bobo-nums/ece445/notebooks/colin/images/powermonitor.png

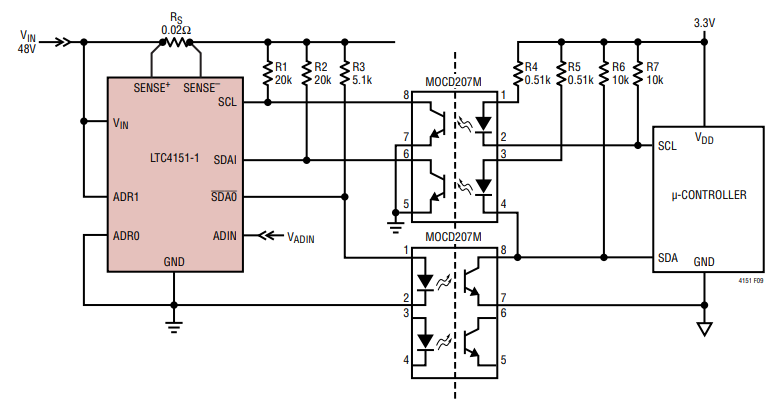
notebooks/colin/images/powermonitor.png
