bobo-nums/ece445/notebooks/colin/images/sepic_schematic.png

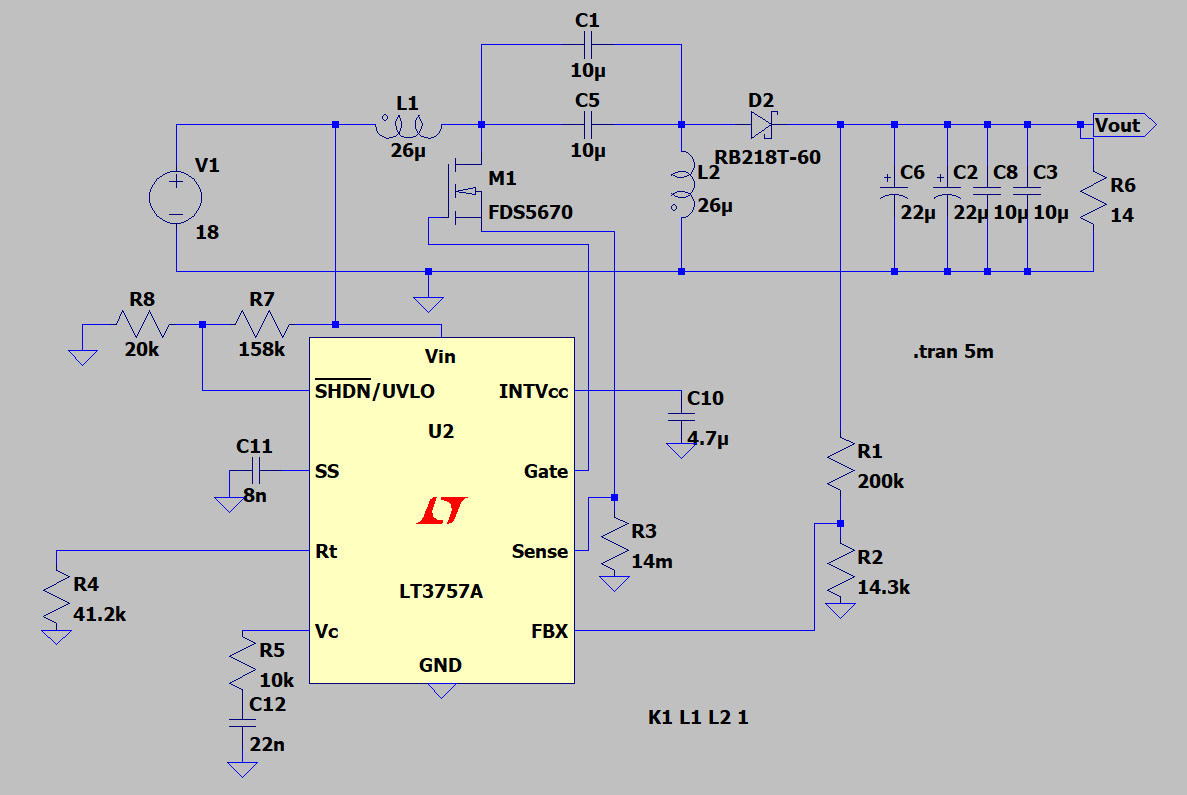
notebooks/colin/images/sepic_schematic.png
