bobo-nums/ece445/notebooks/colin/images/sepic_sim.png

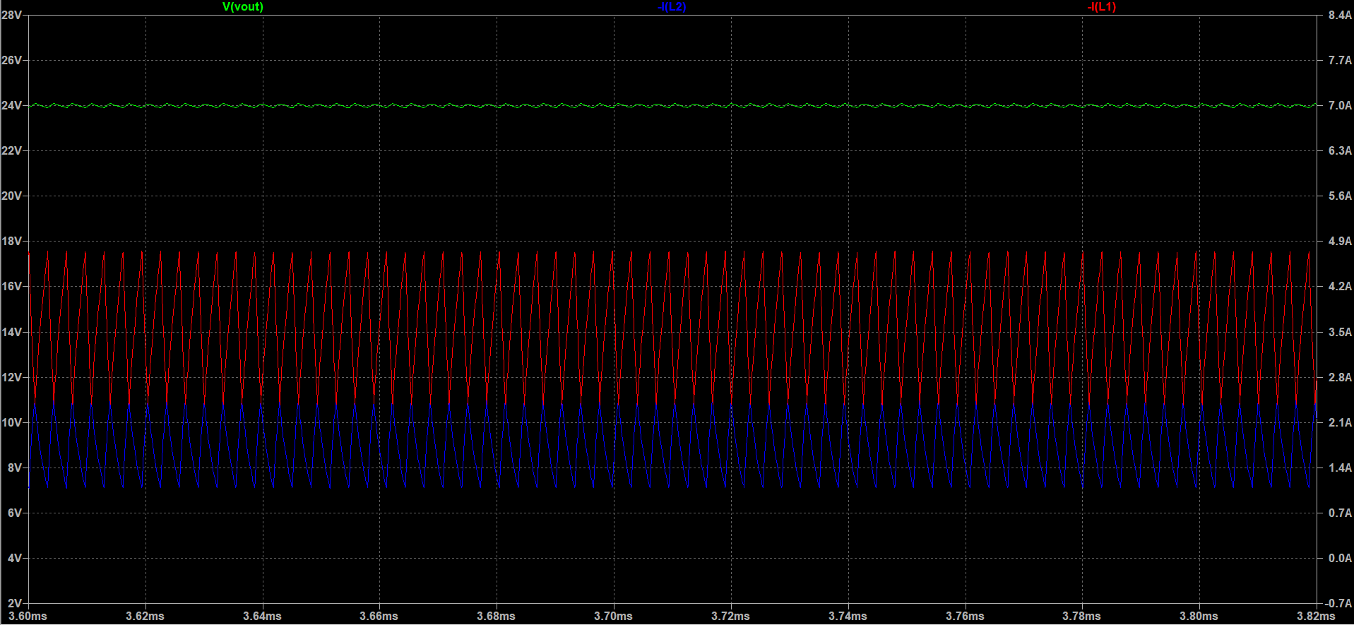
notebooks/colin/images/sepic_sim.png
