bobo-nums/ece445/simulations/3v3 buck/3v3 buck sim waveform.png

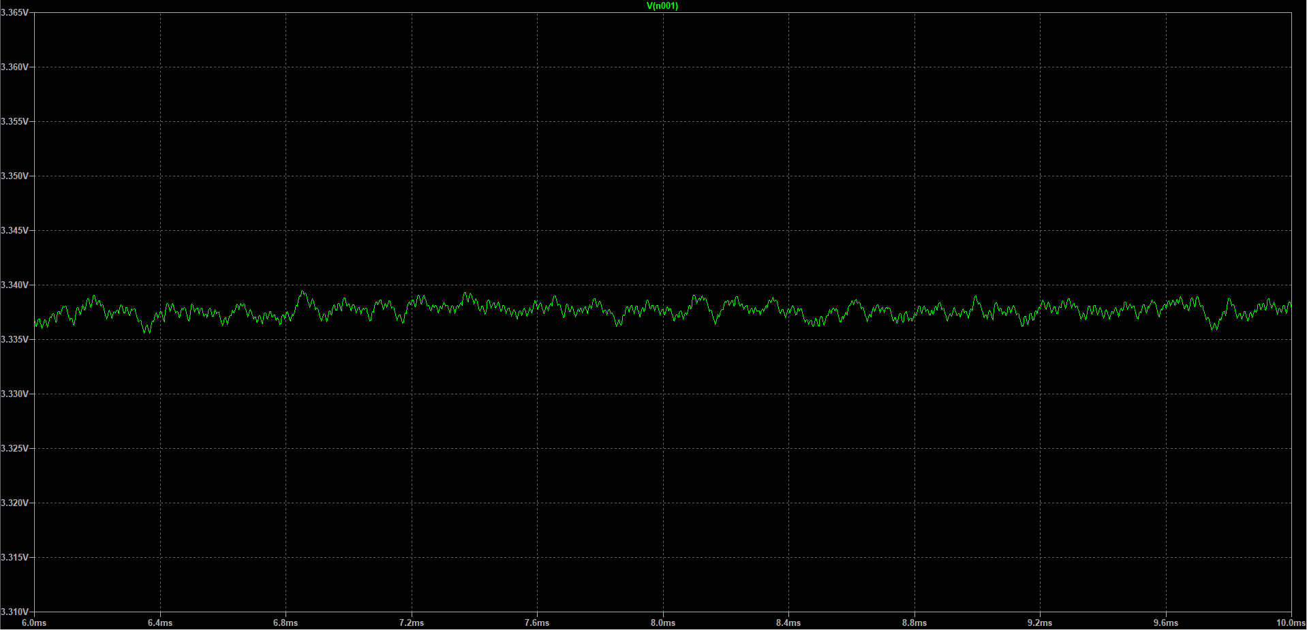
simulations/3v3 buck/3v3 buck sim waveform.png
