bobo-nums/ece445/simulations/5v buck/5v buck sim.png

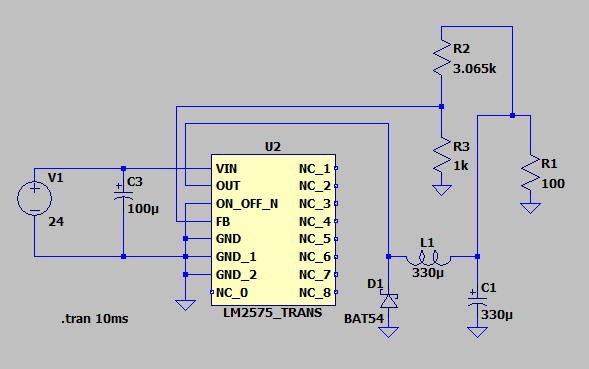
simulations/5v buck/5v buck sim.png
