bobo-nums/ece445/datasheets/components.xlsx

Sheet: Sheet1
Board | Subsystem | Component | Part | Link | Quantity | Comments
 | MCU | 100uF cap | CL31A107MQHNNNE | https://www.digikey.com/en/products/detail/samsung-electro-mechanics/CL31A107MQHNNNE/3887440 | 1
 | MCU | 0.1uF cap | 06036C104KAT4A | https://www.digikey.com/en/products/detail/kyocera-avx/06036C104KAT4A/11244654 | 3
 | MCU | 22pF cap | 06036A220KAT2A | https://www.digikey.com/en/products/detail/kyocera-avx/06036A220KAT2A/1600398 | 2
 | MCU | 10uF cap | JMK107ABJ106MA-T | https://www.digikey.com/en/products/detail/taiyo-yuden/JMK107ABJ106MA-T/4970720 | 1
 | MCU | 10k resistor | RNCP0805FTD10K0 | https://www.digikey.com/en/products/detail/stackpole-electronics-inc/RNCP0805FTD10K0/2240262 | 2
 | MCU | dc/dc | SPBW03F-05 | https://www.mouser.com/ProductDetail/MEAN-WELL/SPBW03F-05?qs=5aG0NVq1C4ygTXk%2FgwDM0Q%3D%3D | 1
 | MCU | button | TS02-66-60-BK-100-LCR-D | https://www.mouser.com/ProductDetail/CUI-Devices/TS02-66-60-BK-100-LCR-D?qs=A6eO%252BMLsxmQEn9GN9b6zGQ%3D%3D | 1
 | MCU | oscillator | AS-16.000-20-EXT | https://www.digikey.com/en/products/detail/raltron-electronics/AS-16-000-20-EXT/10246238 | 1
 | MCU | diode | SBR80520LT1G | https://www.digikey.com/en/products/detail/onsemi/SBR80520LT1G/5969271 | 1
 | MCU
 | MCU
N/A | Sensing | photoresistor | 161 | https://www.digikey.com/en/products/detail/adafruit-industries-llc/161/7244927
N/A | Sensing | Humidity sensor | DHT20 | https://www.sparkfun.com/products/18364
N/A | Sensing | IR sensor | GP2Y0A710K0F | https://www.digikey.com/en/products/detail/sharp-socle-technology/GP2Y0A710K0F/2117639
N/A | MCU | MCU | ATMEGA328-PU | https://www.digikey.com/en/products/detail/microchip-technology/ATMEGA328-PU/2271026 | 1 | Have 2

Sheet: Done
Board | Subsystem | Component | Part | Link | PCB Quantity | Cart Quantity | Purchased | Num
Power | 3.3V buck | 3.3V buck IC | LM2575D2T-3.3R4G | https://www.digikey.com/en/products/detail/onsemi/LM2575D2T-3-3R4G/1476688 | 1 | 1 | Y | 1
Power | 3.3V buck/5V buck | Schottky diode | VS-30WQ04FNTR-M3 | https://www.digikey.com/en/products/detail/vishay-general-semiconductor-diodes-division/VS-30WQ04FNTR-M3/4933687 | 2 | 2 | Y | 1
Power | 3.3V buck/5V buck | 100uF cap | ESY107M050AG3AA | https://www.digikey.com/en/products/detail/kemet/ESY107M050AG3AA/2712537 | 2 | 2 | Y | 1
Power | 3.3V buck/5V buck | 300uH inductor | HCTI-330-5.2 | https://www.digikey.com/en/products/detail/signal-transformer/HCTI-330-5-2/7362985 | 2 | 2 | Y | 1
Power | 3.3V buck/5V buck | 330uF cap | ESY337M025AG8AA | https://www.digikey.com/en/products/detail/kemet/ESY337M025AG8AA/2712527 | 2 | 2 | Y | 1
Power | 5V buck | 5V buck IC | LM2575D2T-5R4G | https://www.digikey.com/en/products/detail/onsemi/LM2575D2T-5R4G/1476691 | 1 | 1 | Y | 1
Power | 24V Converter | 22n cap | 0603ZC223KAT2A | https://www.digikey.com/en/products/detail/kyocera-avx/0603ZC223KAT2A/1600725 | 1 | 2 | Y | 2
Power | 24V Converter | 6.8n cap | 0603B682M500CT | https://www.digikey.com/en/products/detail/walsin-technology-corporation/0603B682M500CT/9354957 | 1 | 2 | Y | 2
Power | 24V Converter | Coupled Inductor | PF0553.153NLT | https://www.digikey.com/en/products/detail/pulse-electronics-power/PF0553-153NLT/2266969 | 1 | 1 | Y | 2
Power | 24V Converter | MOSFET | FDS5670 | https://www.digikey.com/en/products/detail/onsemi/FDS5670/965322 | 1 | 1 | Y | 2
Power | 24V Converter | 10uF Capacitor | CL32A106KLULNNE | https://www.digikey.com/en/products/detail/samsung-electro-mechanics/CL32A106KLULNNE/3888965 | 4 | 5 | Y | 2
Power | 24V Converter | 4.7uF Capacitor | CL21A475KAQNNNE | https://www.digikey.com/en/products/detail/samsung-electro-mechanics/CL21A475KAQNNNE/3886902 | 3 | 4 | Y | 2
Power | 24V Converter | 14mOhm Sense Resistor | WSL2512R0140FTB | https://www.digikey.com/en/products/detail/vishay-dale/WSL2512R0140FTB/9754224 | 1 | 2 | Y | 2
Power | 24V Converter | Schottky diode | SBRT10U60D1-13 | https://www.digikey.com/en/products/detail/diodes-incorporated/SBRT10U60D1-13/5371873 | 1 | 1 | Y | 2
Power | 24V Converter | 22uF Electrolytic Capacitor | UVZ1V220MDD1TD | https://www.digikey.com/en/products/detail/nichicon/UVZ1V220MDD1TD/4342201 | 2 | 2 | Y | 2
Power | 24V Converter | DC/DC Controller | LT3757AIMSE#PBF | https://www.digikey.com/en/products/detail/analog-devices-inc/LT3757AIMSE-PBF/3838483 | 1 | 0 | Y | 2
Power | 24V Converter | 200k res | RMCF1206FT200K | https://www.digikey.com/en/products/detail/stackpole-electronics-inc/RMCF1206FT200K/1759778 | 1 | 2 | Y | 2
Power | 24V Converter | 14.3k res | RMCF0603FT14K3 | https://www.digikey.com/en/products/detail/stackpole-electronics-inc/RMCF0603FT14K3/1761296 | 1 | 10 | Y | 2
Power | 24V Converter | 41.2k res | RMCF0603FT41K2 | https://www.digikey.com/en/products/detail/stackpole-electronics-inc/RMCF0603FT41K2/1761220 | 1 | 10 | Y | 2
Power | 24V Converter | 20k res | RNCP0603FTD20K0 | https://www.digikey.com/en/products/detail/stackpole-electronics-inc/RNCP0603FTD20K0/2240149 | 1 | 2 | Y | 2
Power | 24V Converter | 158k res | RMCF0603FT158K | https://www.digikey.com/en/products/detail/stackpole-electronics-inc/RMCF0603FT158K/1760916 | 1 | 10 | Y | 2
Power | 24V Converter | 10k res | RNCP0603FTD10K0 | https://www.digikey.com/en/products/detail/stackpole-electronics-inc/RNCP0603FTD10K0/2240139 | 1 | 2 | Y | 2
Power | 24V Converter | 4.7u cap | 860160672005 | https://www.digikey.com/en/products/detail/w%C3%BCrth-elektronik/860160672005/5729521 | 2 | 2 | Y | 2
Power | Switching Network | 1 uF capacitor | CL10B105KP8NNNC | https://www.digikey.com/en/products/detail/samsung-electro-mechanics/CL10B105KP8NNNC/3887604 | 4 | 10 | Y | 3
Power | Switching Network | MOSFET | FDD8453LZ | https://www.digikey.com/en/products/detail/onsemi/FDD8453LZ/1768364 | 4 | 4 | Y | 3
Power | Switching Network | Quad High-Side Gate Driver | LT1161IN#PBF | https://www.digikey.com/en/products/detail/analog-devices-inc/LT1161CSW-PBF/889376 | 1 | 1 | Y | 3
Power | Switching Network | 330u cap | UPJ1H331MHD6TN | https://www.digikey.com/en/products/detail/nichicon/UPJ1H331MHD6TN/4319461 | 2 | 2 | Y | 3
Power | Switching Network | 10u cap | GMK325AB7106MMHP | https://www.digikey.com/en/products/detail/taiyo-yuden/GMK325AB7106MMHP/7403987 | 2 | 3 | Y | 3
Power | General | yellow LED | L196L-YC | https://www.digikey.com/en/products/detail/american-opto-plus-led/L196L-YC/12325401 | 1 | 1 | Y | 4
Power | General | 1.5k res | RMCF2512JT1K50 | https://www.digikey.com/en/products/detail/stackpole-electronics-inc/RMCF2512JT1K50/1756956 | 1 | 1 | Y | 4
Power | General | banana connector | 73099-2 | https://www.digikey.com/en/products/detail/pomona-electronics/73099-2/10483465 | 1 | 1 |  | 4
Power | General | banana connector | 73099-0 | https://www.digikey.com/en/products/detail/pomona-electronics/73099-0/10483460 | 1 | 1 |  | 4
Power | Grid Power | AC/DC converter | LM100-23B24 | https://www.digikey.com/en/products/detail/mornsun-america-llc/LM100-23B24/13168375 | 1 | 1 | Y | 5
Power | Power Monitor | Power Monitor (I2C) | LTC4151IMS-1#TRPBF | https://www.digikey.com/en/products/detail/analog-devices-inc/LTC4151IMS-1-TRPBF/1814476 | 1 | 0 | Y | 6
Power | Power Monitor | 0 ohm resistor | HCJ2512ZT0R00 | https://www.digikey.com/en/products/detail/stackpole-electronics-inc/HCJ2512ZT0R00/4357663 | 4 | 5 |  | 6
Power | Power Monitor | Sense Resistor | ERJ-3BWFR020V | https://www.digikey.com/en/products/detail/panasonic-electronic-components/ERJ-3BWFR020V/5647494 | 1 | 2 |  | 6
Power | Power Monitor | optoisolator | MOCD207M | https://www.digikey.com/en/products/detail/fairchild-semiconductor/MOCD207M/281247 | 4 | 4 |  | 6
Power | Power Monitor | MOSFET | FDD8453LZ | https://www.digikey.com/en/products/detail/onsemi/FDD8453LZ/1768364 | 1 | 1 |  | 6
Power | Power Monitor | 20k res | RNCP0603FTD20K0 | https://www.digikey.com/en/products/detail/stackpole-electronics-inc/RNCP0603FTD20K0/2240149 | 2 | 3 |  | 6
Power | Power Monitor | 5.1k res | RMCF0603JT5K10 | https://www.digikey.com/en/products/detail/stackpole-electronics-inc/RMCF0603JT5K10/1757959 | 1 | 10 |  | 6
Power | Power Monitor | 510 res | ESR10EZPJ511 | https://www.digikey.com/en/products/detail/rohm-semiconductor/ESR10EZPJ511/1762828 | 2 | 3 |  | 6
Power | Power Monitor | 10k res | RMCF0805JT10K0 | https://www.digikey.com/en/products/detail/stackpole-electronics-inc/RMCF0805JT10K0/1757762 | 13 | 20 |  | 6
Power | Power Monitor | 33 power res | TEH140M33R0FE | https://www.mouser.com/ProductDetail/Ohmite/TEH140M33R0FE?qs=r5DSvlrkXmJ6291snezuUw%3D%3D | 1 | 1 |  | 6
Power | Power Monitor | 100k res | RMCF1206JT100K | https://www.digikey.com/en/products/detail/stackpole-electronics-inc/RMCF1206JT100K/1757423 | 2 | 10 |  | 6
Power | Power Monitor | power res heat sink | 588-E2A-T247-38E | https://www.mouser.com/ProductDetail/588-E2A-T247-38E | 1 | 1 |  | 6
Lights | Lights | Relay | 1462041-7 | https://www.digikey.com/en/products/detail/te-connectivity-potter-brumfield-relays/1462041-7/2126941 | 1 | 1 |  | 7
Lights | Lights | MOSFET | FDD8453LZ | https://www.digikey.com/en/products/detail/onsemi/FDD8453LZ/1768364 | 4 | 4 |  | 7
Lights | Lights | Screw terminal | TB002-500-02BE | https://www.digikey.com/en/products/detail/cui-devices/TB002-500-02BE/10064069 | 4 | 4 |  | 7
Lights | Lights | Flyback diode | SBR1A20T5-7 | https://www.digikey.com/en/products/detail/diodes-incorporated/SBR1A20T5-7/6051869 | 1 | 2 |  | 7
Lights | Lights | 10k res | RMCF0805JT10K0 | https://www.digikey.com/en/products/detail/stackpole-electronics-inc/RMCF0805JT10K0/1757762 | 6 | 10 |  | 7
Lights | Lights | optoisolator | MOCD207M | https://www.digikey.com/en/products/detail/fairchild-semiconductor/MOCD207M/281247 | 2 | 2 |  | 7
Power | Buttons | button | GPTS203211B | https://www.digikey.com/en/products/detail/cw-industries/GPTS203211B/3190590 | 2 | 2 |  | 8
