bobo-nums/ece445/(list of files, cad)

Other CAD files:
physical design/traffic light.ipt
