bobo-nums/ece445/simulations/another switching network/another switching network.asc

C1: cap; 1µ
C2: cap; 1µ
C3: cap; 1µ
C4: cap; 1µ
C5: polcap; 330µ; V=35 Irms=1.06 Rser=0.06 Lser=0 mfg="Nichicon" pn="UPL1V331MPH" type="Al electrolytic"
C6: polcap; 330µ; V=35 Irms=1.06 Rser=0.06 Lser=0 mfg="Nichicon" pn="UPL1V331MPH" type="Al electrolytic"
C7: cap; 10µ; V=35 Irms=0 Rser=0 Lser=0 mfg="Murata" pn="GRM21BR6YA106KE43" type="X5R"
C8: cap; 10µ; V=35 Irms=0 Rser=0 Lser=0 mfg="Murata" pn="GRM21BR6YA106KE43" type="X5R"
M1: nmos; BSC060N10NS3
M2: nmos; BSC060N10NS3
M3: nmos; BSC060N10NS3
M4: nmos; BSC060N10NS3
R1: res; 15
U1: LT1161
U2: LT1161
V1: voltage; PWL(0 0 5m 0 5.01m 0 9.99m 0 10m 5)
V2: voltage; 24
V4: voltage; 24
V6: voltage; PWL(0 0 4.99m 0 5m 5 9.99m 5 10m 0)
Named nets: 0
.tran 15m
