bobo-nums/ece445/simulations/24v sepic/24v sepic.asc

C1: cap; 10µ; V=25 Irms=18.5 Rser=0.00262245 Lser=0 mfg="KEMET" pn="C1210C106K3RAC" type="X7R"
C2: polcap; 22µ; V=35 Irms=65m Rser=2.3 Lser=0 mfg="Nichicon" pn="UPR1V220MAH" type="Al electrolytic"
C3: cap; 10µ; V=35 Irms=8.06 Rser=0.000077565 Lser=0
C5: cap; 10µ; V=25 Irms=18.5 Rser=0.00262245 Lser=0 mfg="KEMET" pn="C1210C106K3RAC" type="X7R"
C6: polcap; 22µ; V=35 Irms=65m Rser=2.3 Lser=0 mfg="Nichicon" pn="UPR1V220MAH" type="Al electrolytic"
C8: cap; 10µ; V=35 Irms=8.06 Rser=0.00577565 Lser=0 mfg="KEMET" pn="C1210C106K6PAC" type="X5R"
C10: cap; 4.7µ; V=4 Irms=9.29 Rser=0.00646575 Lser=0 mfg="KEMET" pn="C0603C475K7PAC" type="X5R"
C11: cap; 6.8n
C12: cap; 22n
D2: schottky; RB218T-60
L1: ind2; 28µ; Rser=48m
L2: ind2; 28µ; Rser=48m
M1: nmos; FDS5670
R1: res; 200k
R2: res; 14.3k
R3: res; 14m; pwr=1
R4: res; 41.2k
R5: res; 10k
R6: res; 14
R7: res; 158k
R8: res; 20k
U2: LT3757A
V1: voltage; 18
Named nets: Vout, 0
.tran 5m
K1 L1 L2 1
