bobo-nums/ece445/simulations/new switching network/Draft1.asc

C1: cap; 1µ
C2: cap; 1µ
C3: cap; 1µ
C4: cap; 1µ
C5: cap; 220µ
C6: cap; 220µ
D1: schottky; RBQ30TB45B
D2: schottky; RBQ30TB45B
M1: nmos; BSC060N10NS3
M2: nmos; BSC060N10NS3
M3: nmos; BSC060N10NS3
M4: nmos; BSC060N10NS3
R1: res; 14
U1: LT1161
U2: LT1161
V1: voltage; PWL(0 0 5m 0 5.01m 0 9.99m 0 10m 5)
V2: voltage; 24
V3: voltage; PWL(0 5 5m 5 9.99m 5 10m 0)
V4: voltage; 24
V5: voltage; PWL(0 0 5m 0 5.01m 0 9.99m 0 10m 5)
V6: voltage; PWL(0 5 5m 5 9.99m 5 10m 0)
Named nets: 0
.tran 15m
