bobo-nums/ece445/simulations/new switching network/new switching network.asc

C1: cap; 15µ; Rser=0.002
C2: polcap; 470µ; V=450 Irms=1.85 Rser=0.085 Lser=9.61067n mfg="Würth Elektronik" pn="861141486024 WCAP-AI3H 35x50" type="Al electrolytic"
C3: cap; 15µ; Rser=0.002
C6: polcap; 470µ; V=450 Irms=1.85 Rser=0.085 Lser=9.61067n mfg="Würth Elektronik" pn="861141486024 WCAP-AI3H 35x50" type="Al electrolytic"
D3: zener; BZX84C12VL
D4: zener; BZX84C12VL
Q1: nmos; BSC060N10NS3
Q2: nmos; BSC060N10NS3
Q3: nmos; BSC060N10NS3
Q4: nmos; BSC060N10NS3
R1: res; 10k
R2: res; 100k
R3: res; 10k
R4: res; 100k
Rload: res; 24
U1: LTC4359
U2: LTC4359
V1: voltage; 24
V2: voltage; 24
V3: voltage; PWL(0 5 5m 5 5.01m 0)
V4: voltage; PWL(0 0 5m 0 5.01m 5 10m 5)
Named nets: 0
.tran 20m
