bobo-nums/ece445/simulations/5v buck/5v buck.asc

C1: polcap; 330µ
C3: polcap; 100µ
D1: schottky; BAT54
L1: ind; 330µ
R1: res; 100
R2: res; 3.065k
R3: res; 1k
U2: LM2575_TRANS
V1: voltage; 24
Named nets: 0
.tran 10ms
