bobo-nums/ece445/simulations/switching network/switching network.asc

C1: cap; 1.5µ
C2: cap; 1.5µ
D1: zener; TFZ24B
D2: schottky; RBR20BM60A
D3: zener; BZX84C12VL
D4: zener; TFZ24B
D5: schottky; RBR20BM60A
D6: zener; BZX84C12VL
M1: nmos; AONS66612
M2: nmos; BSZ100N06LS3
M3: nmos; AONS66612
M4: nmos; BSZ100N06LS3
R1: res; 1k
R2: res; 100k
R3: res; 1k
R4: res; 100k
R5: res; 10k
R6: res; 10k
S1: sw
SW: sw
U1: LTC4359
U2: LTC4359
V1: voltage; 24
V2: voltage; 24
V3: voltage; PULSE(5 0 0 .5m .5m 1m)
V4: voltage; 5
V5: voltage; PULSE(0 5 0 .5m .5m 1m)
V6: voltage; 5
Named nets: 0
.tran 5m
.model SW SW(Ron=1 Roff=1Meg Vt=.5 Vh=-.4)
