bobo-nums/ece445/kicad/buck_board/buck_board/buck_board.kicad_pcb

## KiCad design kicad/buck_board/buck_board/buck_board.kicad_pcb (2022-03-30)

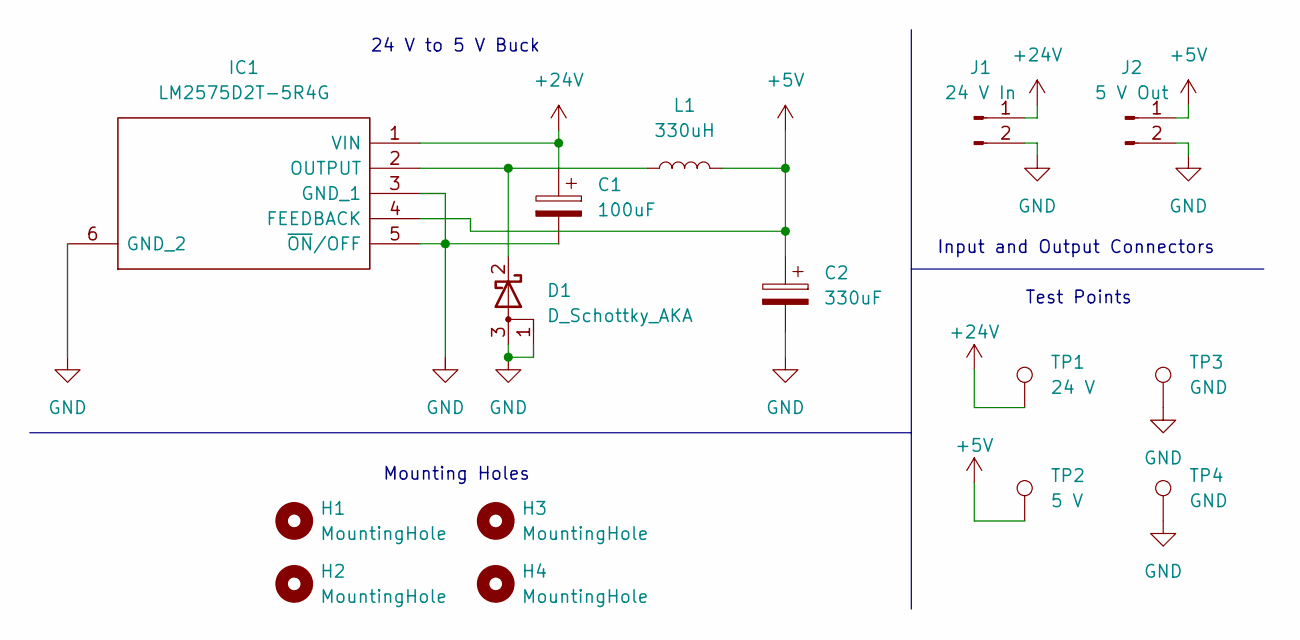
[picture p58: schematic buck_board.kicad_sch]

Parts:
C1: 100uF; CP_Radial_D8.0mm_P3.50mm
C2: 330uF; CP_Radial_D8.0mm_P3.50mm
D1: D_Schottky_AKA; TO-252-2
H1, H2, H3, H4: MountingHole; MountingHole_3.2mm_M3
IC1: LM2575D2T-5R4G; NCP5663DSADJR4G; Mouser Part Number 863-LM2575D2T-5R4G
J1: 24 V In; PinHeader_1x02_P2.54mm_Vertical
J2: 5 V Out; PinHeader_1x02_P2.54mm_Vertical
L1: 330uH; L_Toroid_Vertical_L31.8mm_W15.9mm_P13.50mm_Bourns_5700
TP1: 24 V; TestPoint_THTPad_D2.0mm_Drill1.0mm
TP2: 5 V; TestPoint_THTPad_D2.0mm_Drill1.0mm
TP3, TP4: GND; TestPoint_THTPad_D2.0mm_Drill1.0mm

Connections:
+5V: C2.1, IC1.4 (FEEDBACK), J2.1, L1.2, TP2.1
+24V: C1.1, IC1.1 (VIN), J1.1, TP1.1
GND: C1.2, C2.2, D1.1 (A), D1.3 (A), IC1.3 (GND_1), IC1.5 (~ON/OFF), IC1.6 (GND_2), J1.2, J2.2, TP3.1, TP4.1
unnamed: D1.2 (K), IC1.2 (OUTPUT), L1.1

Notes on the sheet:
Input and Output Connectors
Test Points
Mounting Holes
24 V to 5 V Buck

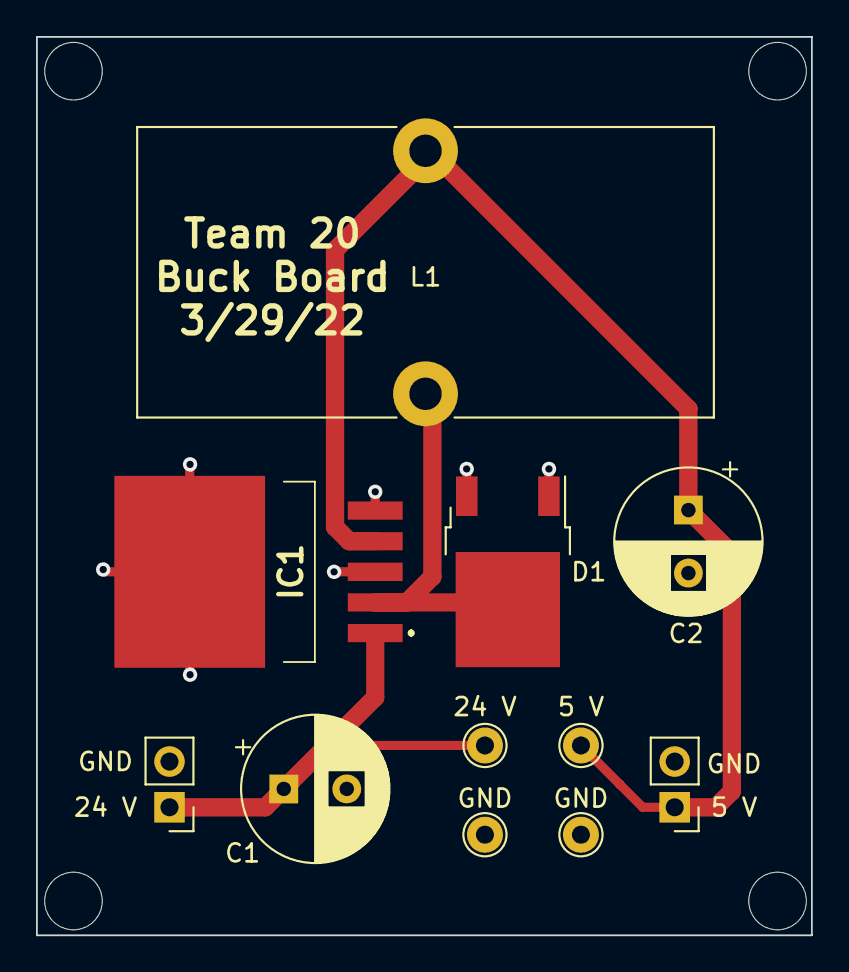
[picture p59: board buck_board.kicad_pcb from above]

Board: 2 copper layers, 43.1 x 49.9 mm, 15 parts (0 on the bottom side), 4 nets.
