bobo-nums/ece445/kicad/light_board/light_board.kicad_pcb

## KiCad design kicad/light_board/light_board.kicad_pcb (2022-03-29)

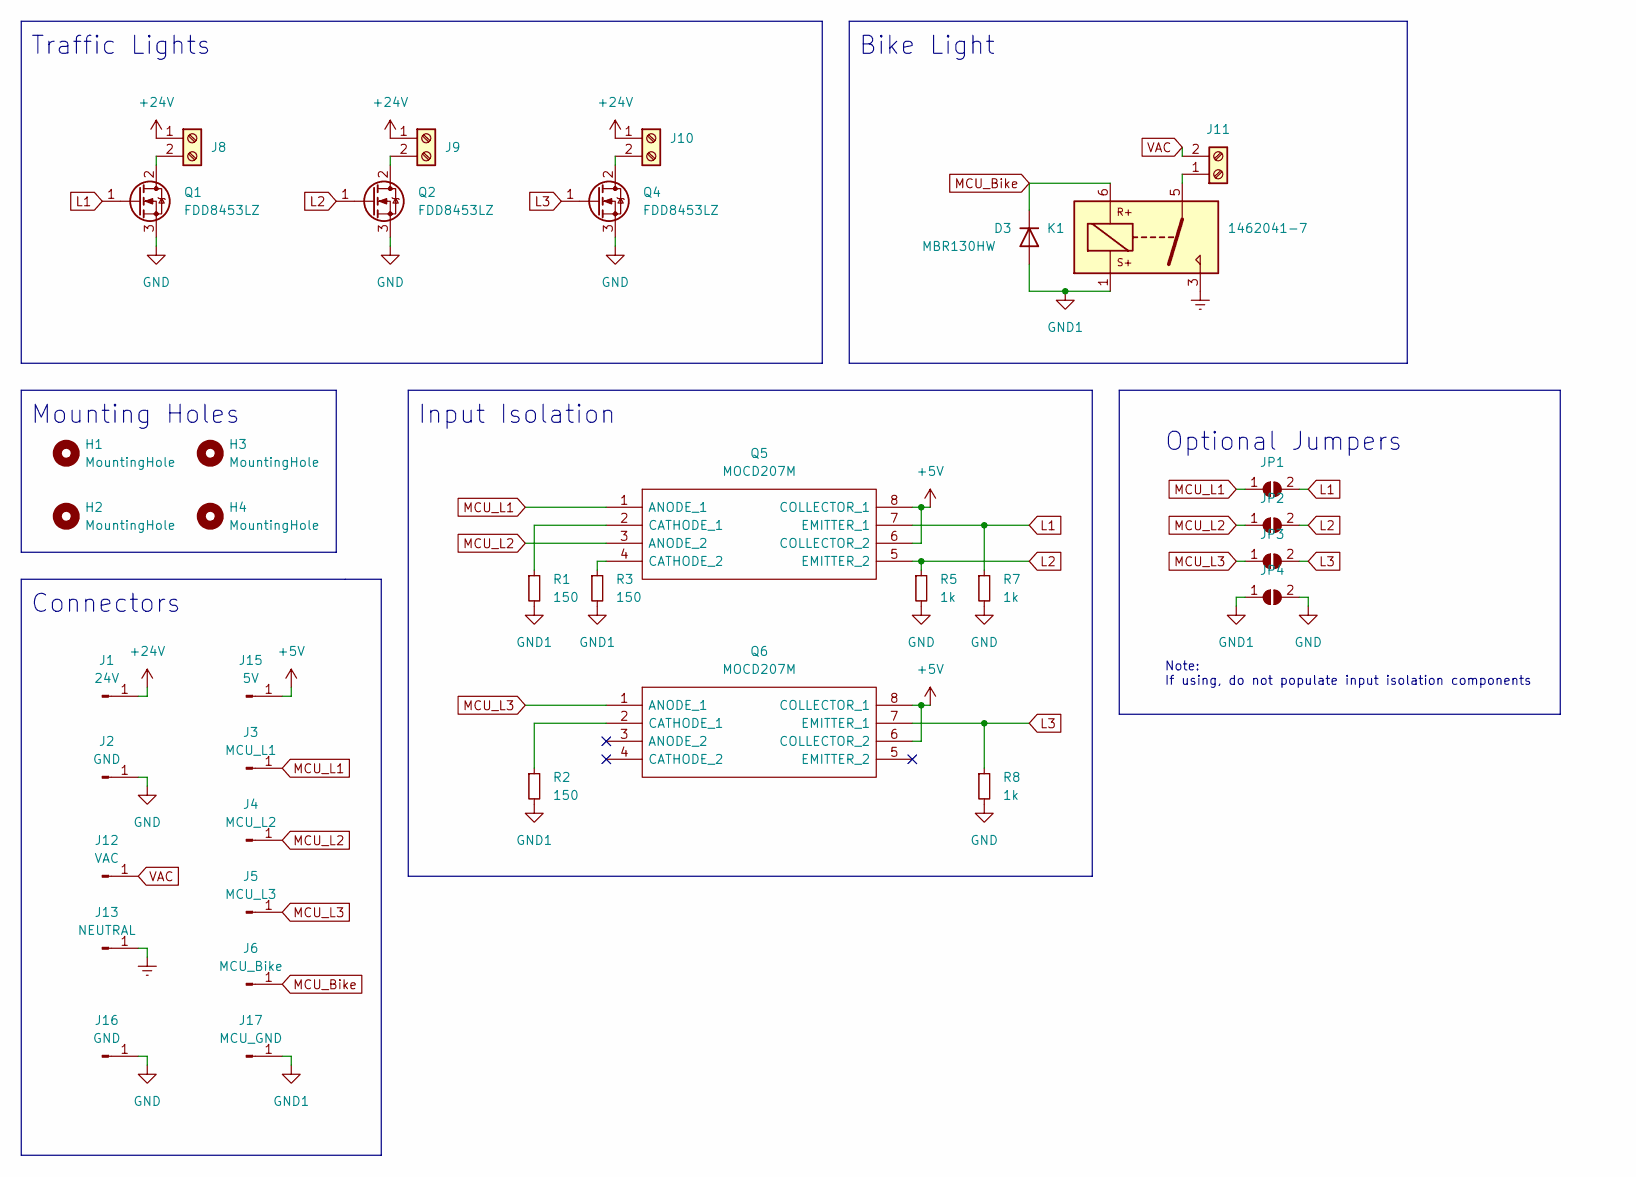
[picture p60: schematic light_board.kicad_sch]

Parts:
D3: MBR130HW; D_SOD-123
H1, H2, H3, H4: MountingHole; MountingHole_3.5mm
J1: 24V; hole
J2: GND; hole
J3: MCU_L1; PinHeader_1x01_P2.54mm_Vertical
J4: MCU_L2; PinHeader_1x01_P2.54mm_Vertical
J5: MCU_L3; PinHeader_1x01_P2.54mm_Vertical
J6: MCU_Bike; PinHeader_1x01_P2.54mm_Vertical
J8, J9, J10, J11: Screw_Terminal_01x02; TerminalBlock_Altech_AK300-2_P5.00mm
J12: VAC; hole
J13: NEUTRAL; hole
J15: 5V; PinHeader_1x01_P2.54mm_Vertical
J16: GND; PinHeader_1x01_P2.54mm_Vertical
J17: MCU_GND; PinHeader_1x01_P2.54mm_Vertical
JP1, JP2, JP3, JP4: SolderJumper_2_Open; SolderJumper-2_P1.3mm_Open_TrianglePad1.0x1.5mm
K1: 1462041-7
Q1, Q2, Q4: FDD8453LZ; TO-252-2
Q5, Q6: MOCD207M; SOIC-8_3.9x4.9mm_P1.27mm; Mouser Part Number 512-MOCD207M
R1, R2, R3: 150; R_0603_1608Metric
R5, R7, R8: 1k; R_0603_1608Metric

Connections:
+5V: J15.1, Q5.6 (COLLECTOR_2), Q5.8 (COLLECTOR_1), Q6.6 (COLLECTOR_2), Q6.8 (COLLECTOR_1)
+24V: J1.1, J8.1, J9.1, J10.1
Earth: J13.1, K1.3
GND: J2.1, J16.1, JP4.2 (B), Q1.3 (S), Q2.3 (S), Q4.3 (S), R5.2, R7.2, R8.2
GND1: D3.2 (A), J17.1, JP4.1 (A), K1.1, R1.2, R2.2, R3.2
L1: JP1.2 (B), Q1.1 (G), Q5.7 (EMITTER_1), R7.1
L2: JP2.2 (B), Q2.1 (G), Q5.5 (EMITTER_2), R5.1
L3: JP3.2 (B), Q4.1 (G), Q6.7 (EMITTER_1), R8.1
MCU_Bike: D3.1 (K), J6.1, K1.6
MCU_L1: J3.1, JP1.1 (A), Q5.1 (ANODE_1)
MCU_L2: J4.1, JP2.1 (A), Q5.3 (ANODE_2)
MCU_L3: J5.1, JP3.1 (A), Q6.1 (ANODE_1)
unnamed: J8.2, Q1.2 (D)
unnamed: J9.2, Q2.2 (D)
unnamed: J10.2, Q4.2 (D)
unnamed: J11.1, K1.5
unnamed: Q5.2 (CATHODE_1), R1.1
unnamed: Q5.4 (CATHODE_2), R3.1
unnamed: Q6.2 (CATHODE_1), R2.1
VAC: J11.2, J12.1

Notes on the sheet:
Input Isolation
Mounting Holes
Connectors
Optional Jumpers
Bike Light
Note: If using, do not populate input isolation components
Traffic Lights

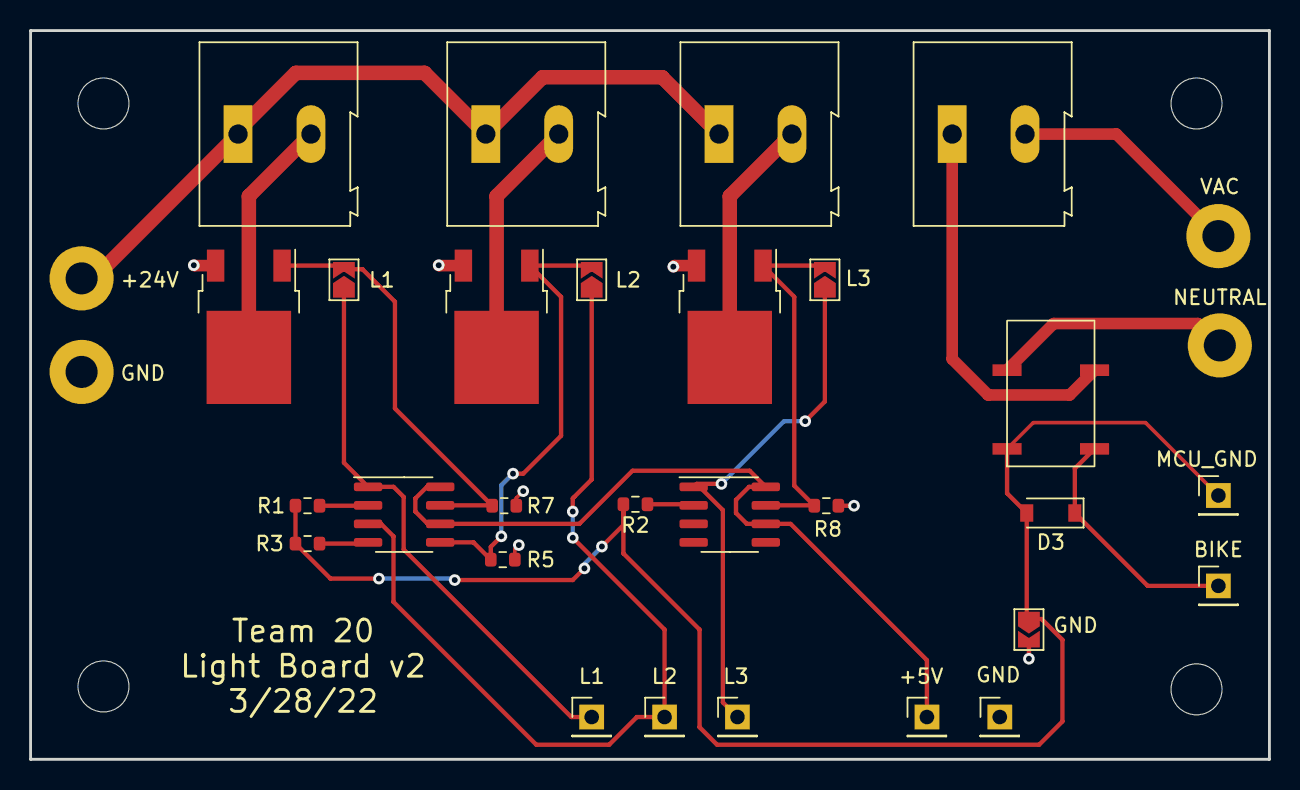
[picture p61: board light_board.kicad_pcb from above]

Board: 2 copper layers, 85.0 x 50.0 mm, 36 parts (0 on the bottom side), 20 nets.
