bobo-nums/ece445/kicad/power_board/power_board.kicad_pcb

## KiCad design kicad/power_board/power_board.kicad_pcb (2022-03-29)

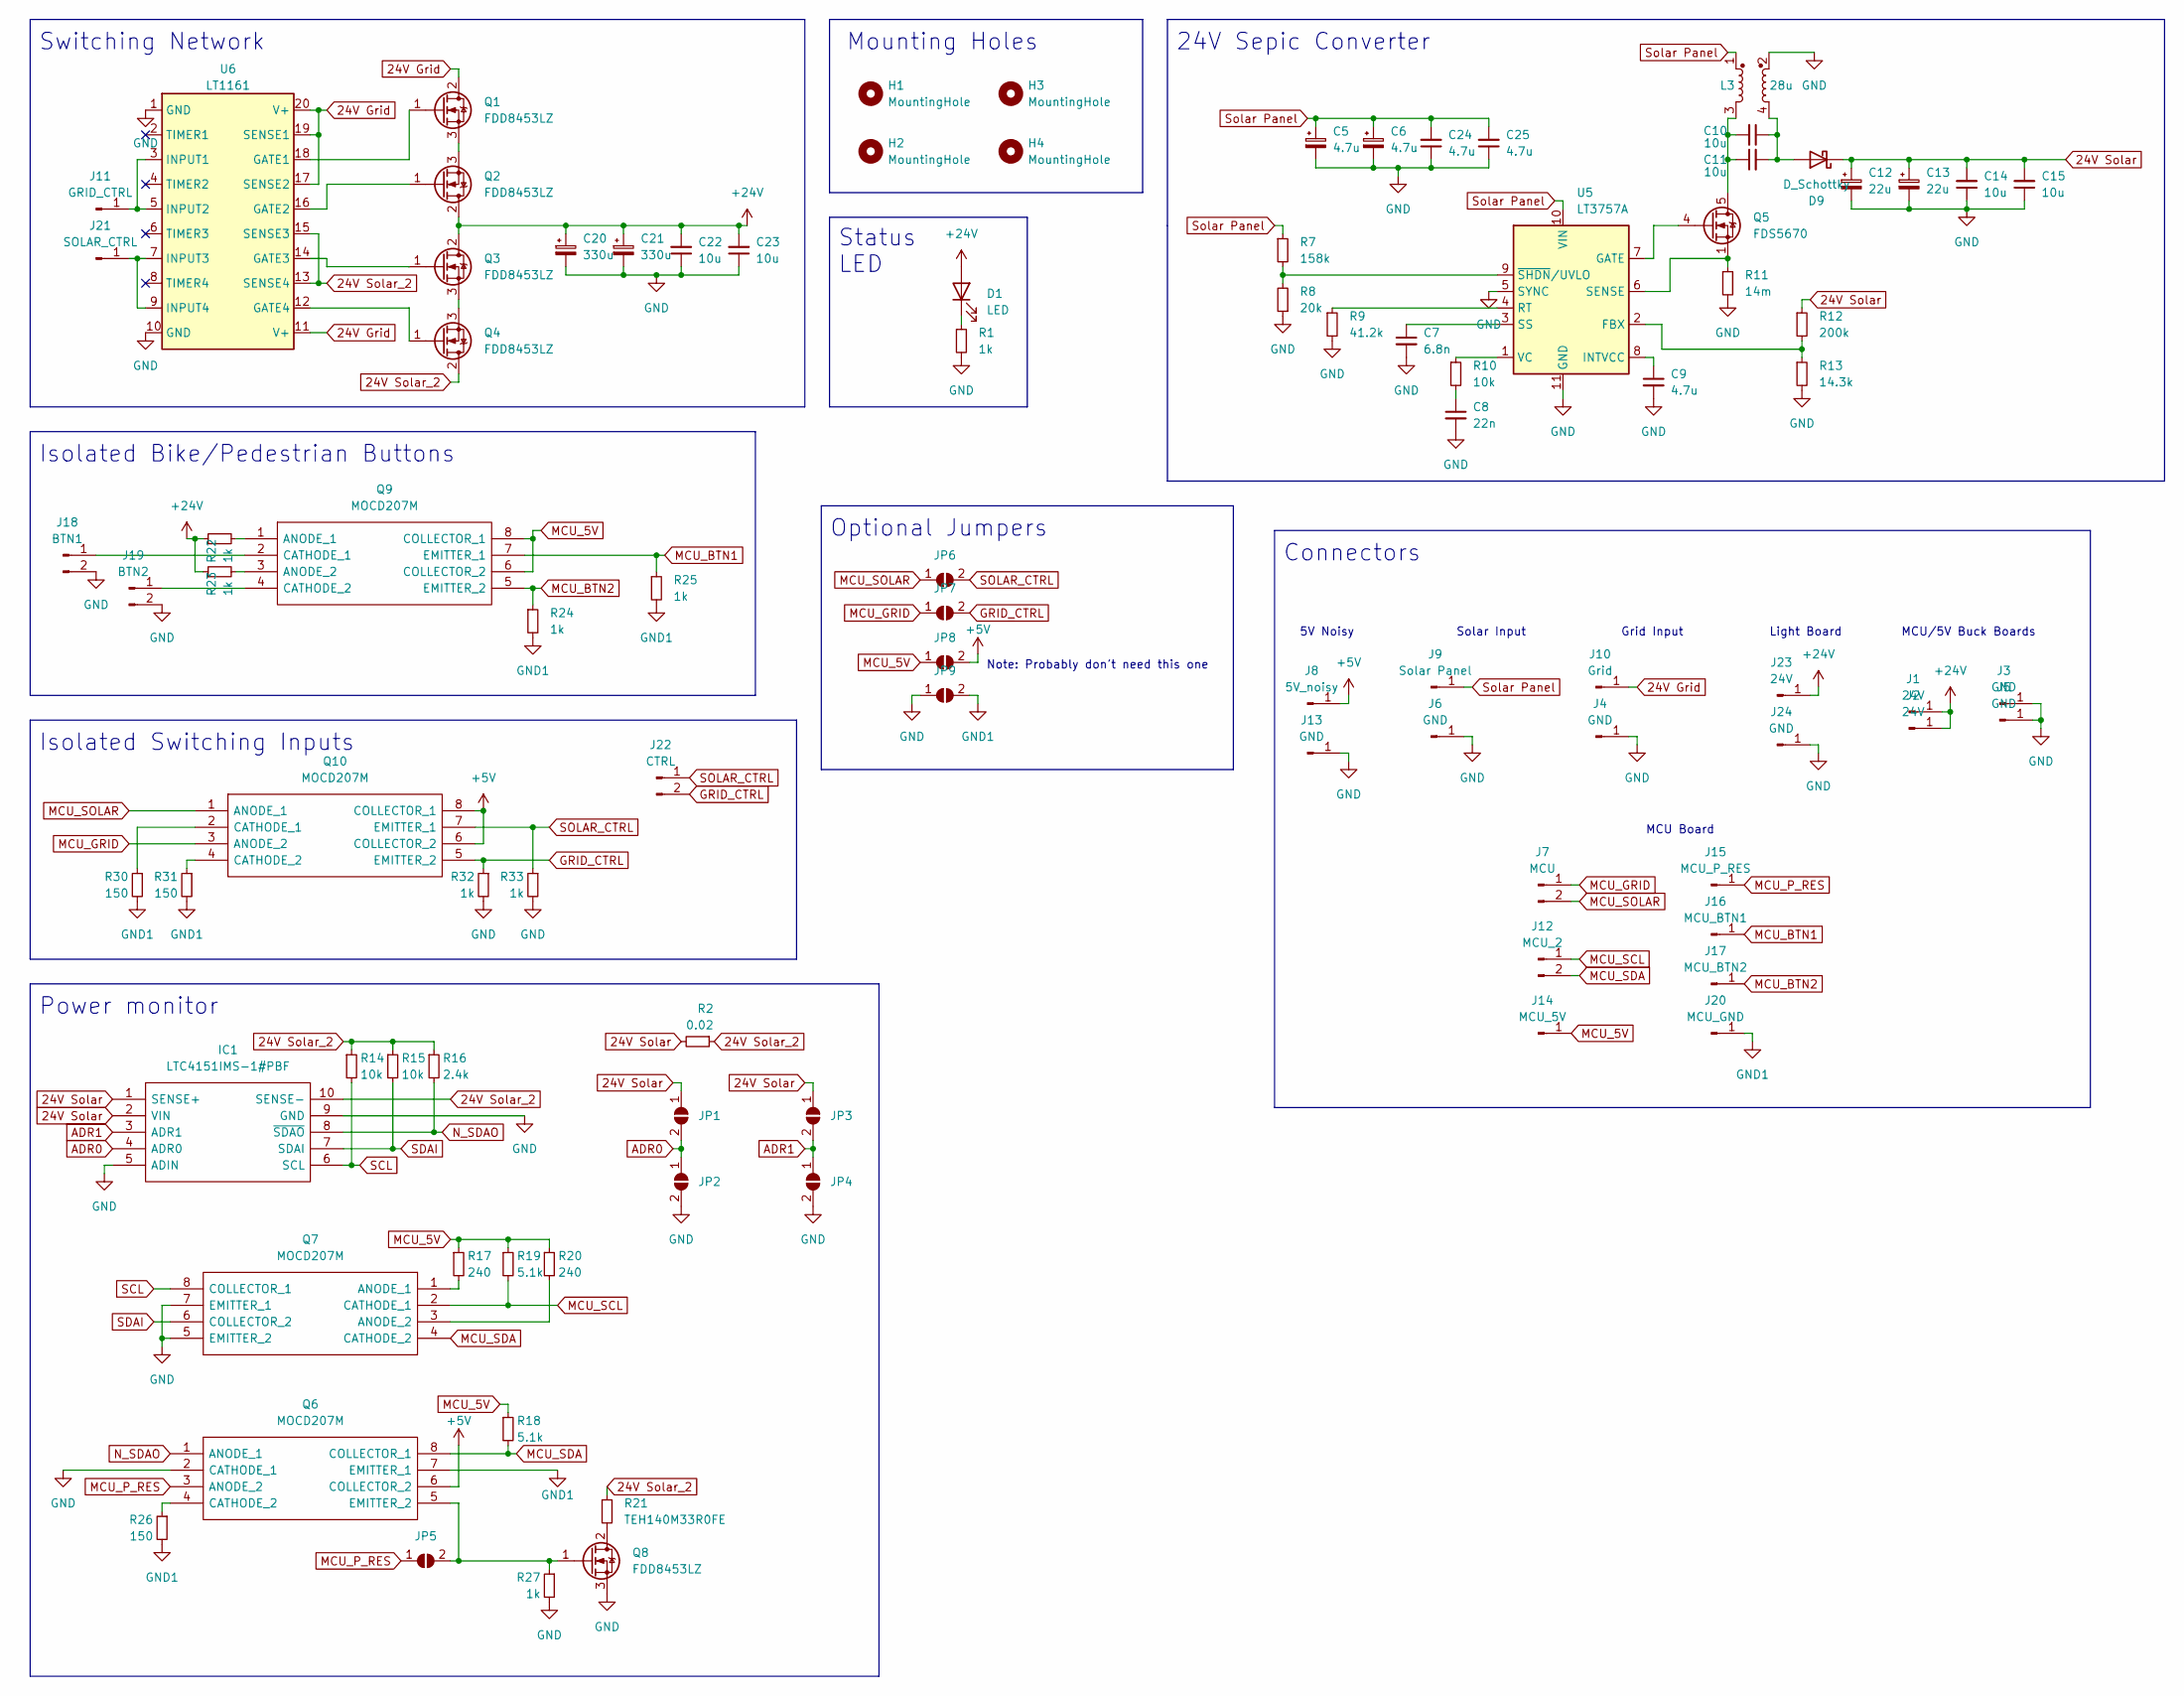
[picture p62: schematic power_board.kicad_sch]

Parts:
C5, C6: 4.7u; CP_Radial_D5.0mm_P2.00mm
C7: 6.8n; C_0603_1608Metric
C8: 22n; C_0603_1608Metric
C9, C24, C25: 4.7u; C_0805_2012Metric
C10, C11, C14, C15, C22, C23: 10u; C_1210_3225Metric
C12, C13: 22u; CP_Radial_D5.0mm_P2.50mm
C20, C21: 330u; C_Radial_D16.0mm_H25.0mm_P7.50mm
D1: LED; C_0603_1608Metric
D9: D_Schottky; TO-252-2
H1, H2, H3, H4: MountingHole; MountingHole_3.5mm
IC1: LTC4151IMS-1#PBF; MSOP-10_3x3mm_P0.5mm; Mouser Part Number 584-LTC4151IMS-1#PBF
J1, J2: 24V; PinHeader_1x01_P2.54mm_Vertical
J3, J5, J13: GND; PinHeader_1x01_P2.54mm_Vertical
J4, J24: GND; hole
J6: GND; hole_1.6mm
J7: MCU; PinHeader_1x02_P2.54mm_Vertical
J8: 5V_noisy; PinHeader_1x01_P2.54mm_Vertical
J9: Solar Panel; hole_1.6mm
J10: Grid; hole
J11: GRID_CTRL; PinHeader_1x01_P2.54mm_Vertical
J12: MCU_2; PinHeader_1x02_P2.54mm_Vertical
J14: MCU_5V; PinHeader_1x01_P2.54mm_Vertical
J15: MCU_P_RES; PinHeader_1x01_P2.54mm_Vertical
J16: MCU_BTN1; PinHeader_1x01_P2.54mm_Vertical
J17: MCU_BTN2; PinHeader_1x01_P2.54mm_Vertical
J18: BTN1; PinHeader_1x02_P2.54mm_Vertical
J19: BTN2; PinHeader_1x02_P2.54mm_Vertical
J20: MCU_GND; PinHeader_1x01_P2.54mm_Vertical
J21: SOLAR_CTRL; PinHeader_1x01_P2.54mm_Vertical
J22: CTRL; PinHeader_1x02_P2.54mm_Vertical
J23: 24V; hole
JP1, JP2, JP3, JP4, JP5, JP6, JP7, JP8, JP9: SolderJumper_2_Open; SolderJumper-2_P1.3mm_Open_TrianglePad1.0x1.5mm
L3: 28u; PF0553NL
Q1, Q2, Q3, Q4, Q8: FDD8453LZ; TO-252-2
Q5: FDS5670; SOIC-8_3.9x4.9mm_P1.27mm
Q6, Q7, Q9, Q10: MOCD207M; SOIC-8_3.9x4.9mm_P1.27mm; Mouser Part Number 512-MOCD207M
R1, R22, R23, R24, R25, R27, R32, R33: 1k; R_0603_1608Metric
R2: 0.02; R_0603_1608Metric
R7: 158k; R_0603_1608Metric
R8: 20k; R_0603_1608Metric
R9: 41.2k; R_0603_1608Metric
R10, R14, R15: 10k; R_0603_1608Metric
R11: 14m; R_2512_6332Metric
R12: 200k; R_1206_3216Metric
R13: 14.3k; R_0603_1608Metric
R16: 2.4k; R_0603_1608Metric
R17, R20: 240; R_0603_1608Metric
R18, R19: 5.1k; R_0603_1608Metric
R21: TEH140M33R0FE; TEH140
R26, R30, R31: 150; R_0603_1608Metric
U5: LT3757A; MSOP-10-1EP_3x3mm_P0.5mm_EP1.68x1.88mm
U6: LT1161; SOIC-20W_7.5x12.8mm_P1.27mm

Connections:
24V Grid: J10.1, Q1.2 (D), U6.11 (V+), U6.17 (SENSE2), U6.19 (SENSE1), U6.20 (V+)
24V Solar: C12.1, C13.1, C14.2, C15.2, D9.2 (K), IC1.1 (SENSE+), IC1.2 (VIN), JP1.1 (A), JP3.1 (A), R2.2, R12.1
24V Solar_2: IC1.10 (SENSE-), Q4.2 (D), R2.1, R14.1, R15.1, R16.1, R21.1, U6.13 (SENSE4), U6.15 (SENSE3)
+5V: J8.1, JP8.2 (B), Q6.6 (COLLECTOR_2), Q10.6 (COLLECTOR_2), Q10.8 (COLLECTOR_1)
+24V: C20.1, C21.1, C22.2, C23.2, D1.2 (A), J1.1, J2.1, J23.1, Q2.2 (D), Q3.2 (D), R22.1, R23.1
ADR0: IC1.4 (ADR0), JP1.2 (B), JP2.1 (A)
ADR1: IC1.3 (ADR1), JP3.2 (B), JP4.1 (A)
GND: C5.2, C6.2, C7.2, C8.2, C9.2, C12.2, C13.2, C14.1, C15.1, C20.2, C21.2, C22.1, C23.1, C24.1, C25.1, IC1.5 (ADIN), IC1.9 (GND), J3.1, J4.1, J5.1, J6.1, J13.1, J18.2, J19.2, J24.1, JP2.2 (B), JP4.2 (B), JP9.1 (A), L3.2, Q6.2 (CATHODE_1), Q7.5 (EMITTER_2), Q7.7 (EMITTER_1), Q8.3 (S), R1.2, R8.1, R9.2, R11.2, R13.2, R27.2, R32.2, R33.2, U5.5 (SYNC), U5.11 (GND), U6.1 (GND), U6.10 (GND)
GND1: J20.1, JP9.2 (B), Q6.7 (EMITTER_1), R24.2, R25.2, R26.2, R30.2, R31.2
GRID_CTRL: J22.2, JP7.2 (B), Q10.5 (EMITTER_2), R32.1
MCU_5V: J14.1, JP8.1 (A), Q9.6 (COLLECTOR_2), Q9.8 (COLLECTOR_1), R17.1, R18.1, R19.1, R20.1
MCU_BTN1: J16.1, Q9.7 (EMITTER_1), R25.1
MCU_BTN2: J17.1, Q9.5 (EMITTER_2), R24.1
MCU_GRID: J7.1, JP7.1 (A), Q10.3 (ANODE_2)
MCU_P_RES: J15.1, JP5.1 (A), Q6.3 (ANODE_2)
MCU_SCL: J12.1, Q7.2 (CATHODE_1), R19.2
MCU_SDA: J12.2, Q6.8 (COLLECTOR_1), Q7.4 (CATHODE_2), R18.2
MCU_SOLAR: J7.2, JP6.1 (A), Q10.1 (ANODE_1)
N_SDAO: IC1.8 (~SDAO), Q6.1 (ANODE_1), R16.2
unnamed: C7.1, U5.3 (SS)
unnamed: C8.1, R10.2
unnamed: C9.1, U5.8 (INTVCC)
unnamed: C10.1, C11.2, D9.1 (A), L3.4
unnamed: C10.2, C11.1, L3.3, Q5.5 (D), Q5.6 (S), Q5.7 (S), Q5.8 (S)
unnamed: D1.1 (K), R1.1
unnamed: J11.1, U6.3 (INPUT1), U6.5 (INPUT2)
unnamed: J18.1, Q9.2 (CATHODE_1)
unnamed: J19.1, Q9.4 (CATHODE_2)
unnamed: J21.1, U6.7 (INPUT3), U6.9 (INPUT4)
unnamed: Q1.1 (G), U6.18 (GATE1)
unnamed: Q1.3 (S), Q2.3 (S)
unnamed: Q2.1 (G), U6.16 (GATE2)
unnamed: Q3.1 (G), U6.14 (GATE3)
unnamed: Q3.3 (S), Q4.3 (S)
unnamed: Q4.1 (G), U6.12 (GATE4)
unnamed: Q5.1 (S), Q5.2 (S), Q5.3 (S), R11.1, U5.6 (SENSE)
unnamed: Q5.4 (G), U5.7 (GATE)
unnamed: Q6.4 (CATHODE_2), R26.1
unnamed: JP5.2 (B), Q6.5 (EMITTER_2), Q8.1 (G), R27.1
unnamed: Q7.1 (ANODE_1), R17.2
unnamed: Q7.3 (ANODE_2), R20.2
unnamed: Q8.2 (D), R21.2
unnamed: Q9.1 (ANODE_1), R22.2
unnamed: Q9.3 (ANODE_2), R23.2
unnamed: Q10.2 (CATHODE_1), R30.1
unnamed: Q10.4 (CATHODE_2), R31.1
unnamed: R7.2, R8.2, U5.9 (~SHDN/UVLO)
unnamed: R9.1, U5.4 (RT)
unnamed: R10.1, U5.1 (VC)
unnamed: R12.2, R13.1, U5.2 (FBX)
SCL: IC1.6 (SCL), Q7.8 (COLLECTOR_1), R14.2
SDAI: IC1.7 (SDAI), Q7.6 (COLLECTOR_2), R15.2
SOLAR_CTRL: J22.1, JP6.2 (B), Q10.7 (EMITTER_1), R33.1
Solar Panel: C5.1, C6.1, C24.2, C25.2, J9.1, L3.1, R7.1, U5.10 (VIN)

Notes on the sheet:
MCU Board
Power monitor
24V Sepic Converter
Note: Probably don't need this one
Connectors
Status LED
Isolated Switching Inputs
Solar Input
Mounting Holes
Grid Input
5V Noisy
Light Board
Isolated Bike/Pedestrian Buttons
Optional Jumpers
MCU/5V Buck Boards
Switching Network

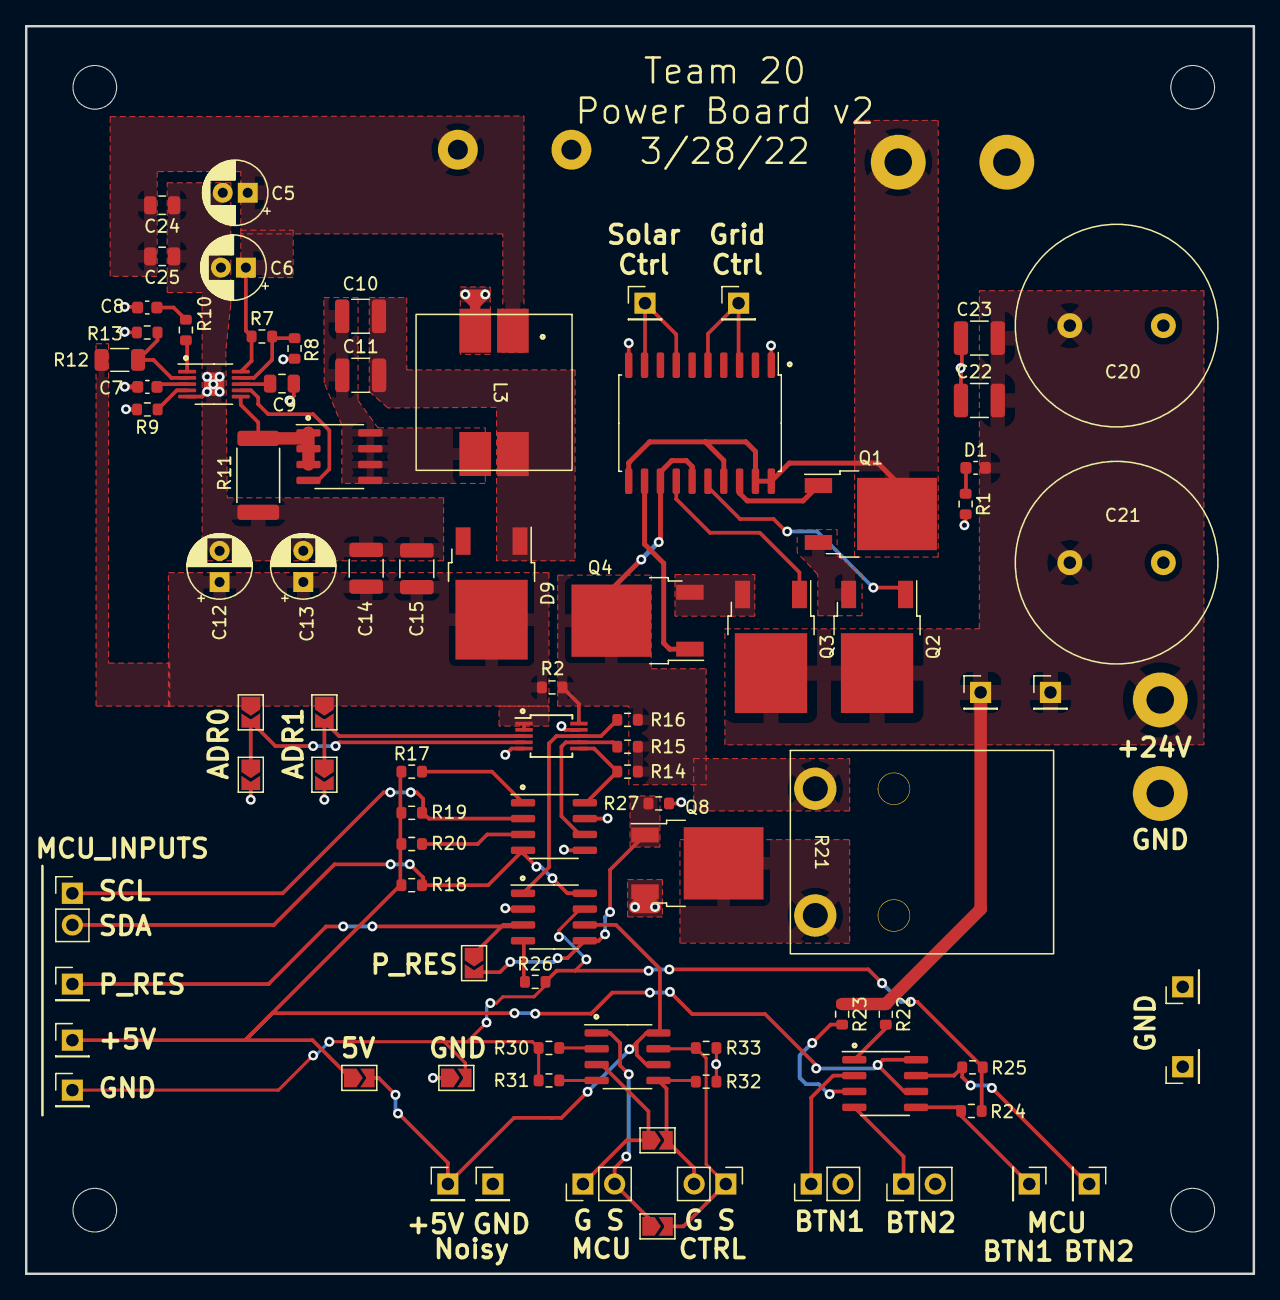
[picture p63: board power_board.kicad_pcb from above]

Board: 2 copper layers, 98.4 x 100.0 mm, 97 parts (0 on the bottom side), 54 nets.
