bobo-nums/ece445/kicad/mcu_board/mcu_board.kicad_pcb

## KiCad design kicad/mcu_board/mcu_board.kicad_pcb (2022-03-08)

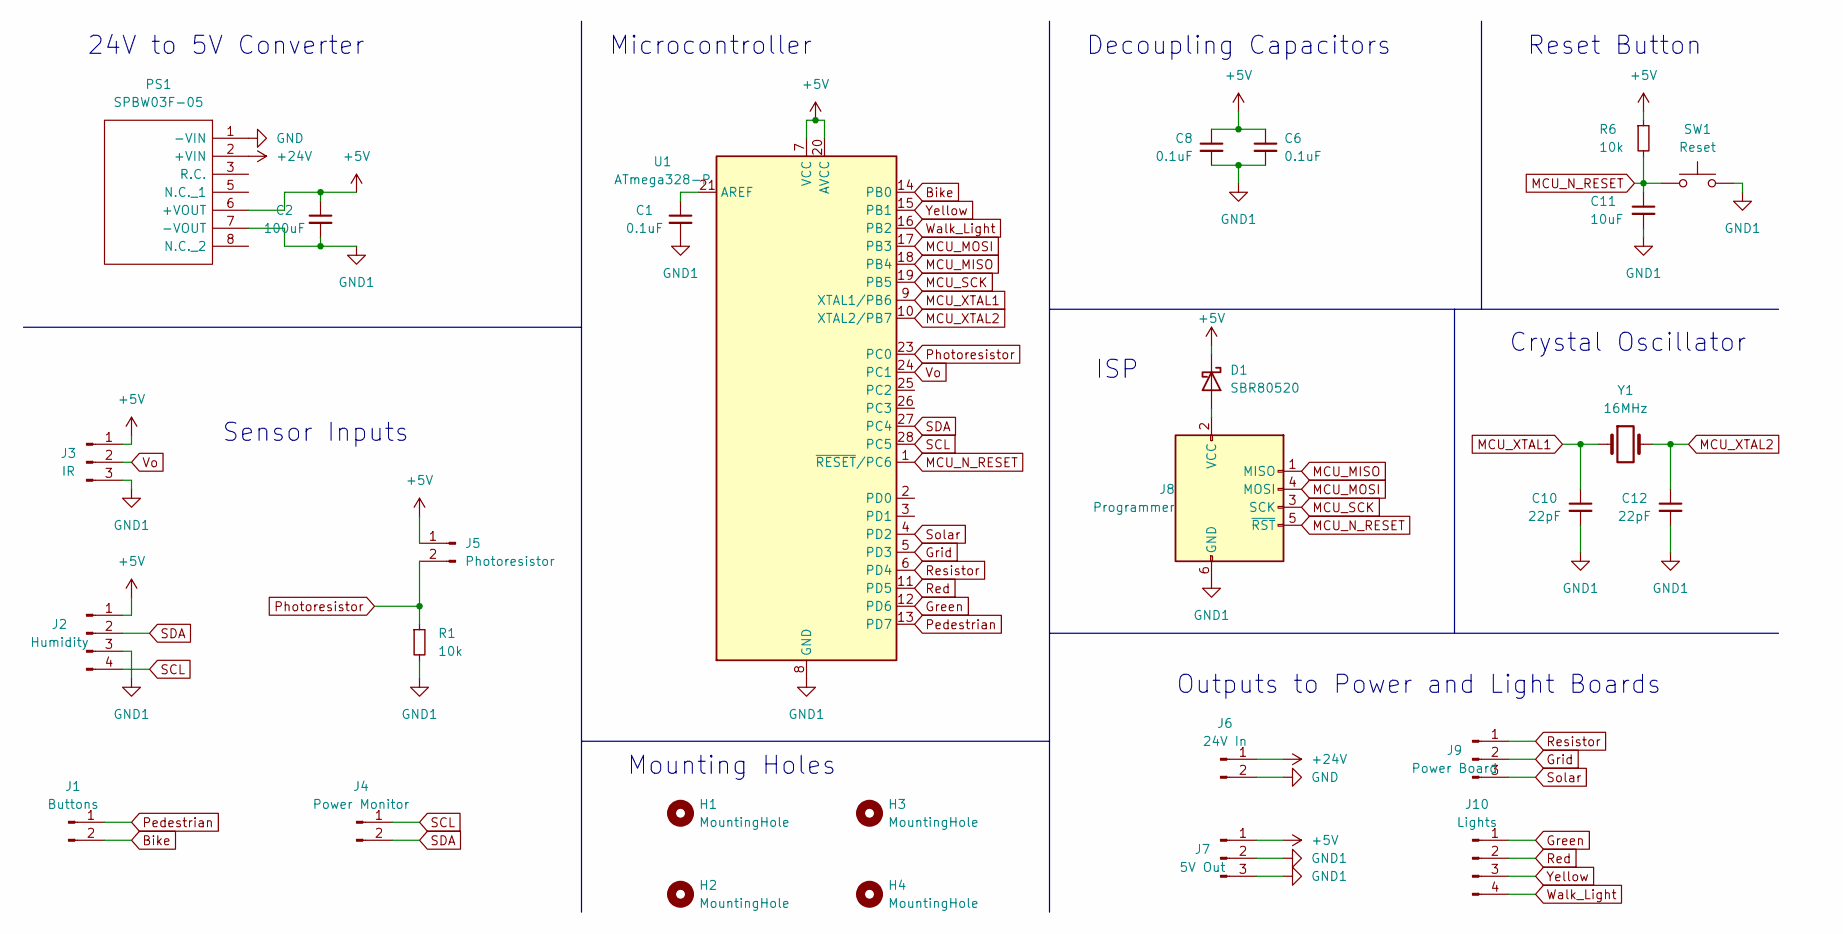
[picture p64: schematic mcu_board.kicad_sch]

Parts:
C1, C6, C8: 0.1uF; C_0603_1608Metric_Pad1.08x0.95mm_HandSolder
C2: 100uF; C_1206_3216Metric_Pad1.33x1.80mm_HandSolder
C10, C12: 22pF; C_0603_1608Metric_Pad1.08x0.95mm_HandSolder
C11: 10uF; C_0603_1608Metric_Pad1.08x0.95mm_HandSolder
D1: SBR80520; D_SOD-123
H1, H2, H3, H4: MountingHole; MountingHole_3.2mm_M3
J1: Buttons; PinHeader_1x02_P2.54mm_Vertical
J2: Humidity; PinHeader_1x04_P2.54mm_Vertical
J3: IR; PinHeader_1x03_P2.54mm_Vertical
J4: Power Monitor; PinHeader_1x02_P2.54mm_Vertical
J5: Photoresistor; PinHeader_1x02_P2.54mm_Vertical
J6: 24V In; PinHeader_1x02_P2.54mm_Vertical
J7: 5V Out; PinHeader_1x03_P2.54mm_Vertical
J8: Programmer; IDC-Header_2x03_P2.54mm_Vertical
J9: Power Board; PinHeader_1x03_P2.54mm_Vertical
J10: Lights; PinHeader_1x04_P2.54mm_Vertical
PS1: SPBW03F-05; SPBW06F05; Mouser Part Number 709-SPBW03F-05
R1, R6: 10k; R_0805_2012Metric_Pad1.20x1.40mm_HandSolder
SW1: Reset; SW_SPST_TL3305B
U1: ATmega328-P; DIP-28_W7.62mm
Y1: 16MHz; Crystal_HC49-U_Vertical

Connections:
+5V: C2.1, C6.1, C8.1, D1.1 (K), J2.1, J3.1, J5.1, J7.1, PS1.6 (+VOUT), R6.1, U1.7 (VCC), U1.20 (AVCC)
+24V: J6.1, PS1.2 (+VIN)
Bike: J1.2, U1.14 (PB0)
GND: J6.2, PS1.1 (-VIN)
GND1: C1.2, C2.2, C6.2, C8.2, C10.2, C11.2, C12.2, J2.3, J3.3, J7.2, J7.3, J8.6 (GND), PS1.7 (-VOUT), R1.2, SW1.2, U1.8 (GND), U1.22 (GND)
Green: J10.1, U1.12 (PD6)
Grid: J9.2, U1.5 (PD3)
MCU_MISO: J8.1 (MISO), U1.18 (PB4)
MCU_MOSI: J8.4 (MOSI), U1.17 (PB3)
MCU_N_RESET: C11.1, J8.5 (~RST), R6.2, SW1.1, U1.1 (~RESET/PC6)
MCU_SCK: J8.3 (SCK), U1.19 (PB5)
MCU_XTAL1: C10.1, U1.9 (XTAL1/PB6), Y1.1
MCU_XTAL2: C12.1, U1.10 (XTAL2/PB7), Y1.2
unnamed: C1.1, U1.21 (AREF)
unnamed: D1.2 (A), J8.2 (VCC)
Pedestrian: J1.1, U1.13 (PD7)
Photoresistor: J5.2, R1.1, U1.23 (PC0)
Red: J10.2, U1.11 (PD5)
Resistor: J9.1, U1.6 (PD4)
SCL: J2.4, J4.1, U1.28 (PC5)
SDA: J2.2, J4.2, U1.27 (PC4)
Solar: J9.3, U1.4 (PD2)
Vo: J3.2, U1.24 (PC1)
Walk_Light: J10.4, U1.16 (PB2)
Yellow: J10.3, U1.15 (PB1)

Notes on the sheet:
ISP
Outputs to Power and Light Boards
Mounting Holes
Crystal Oscillator
Reset Button
24V to 5V Converter
Decoupling Capacitors
Sensor Inputs
Microcontroller

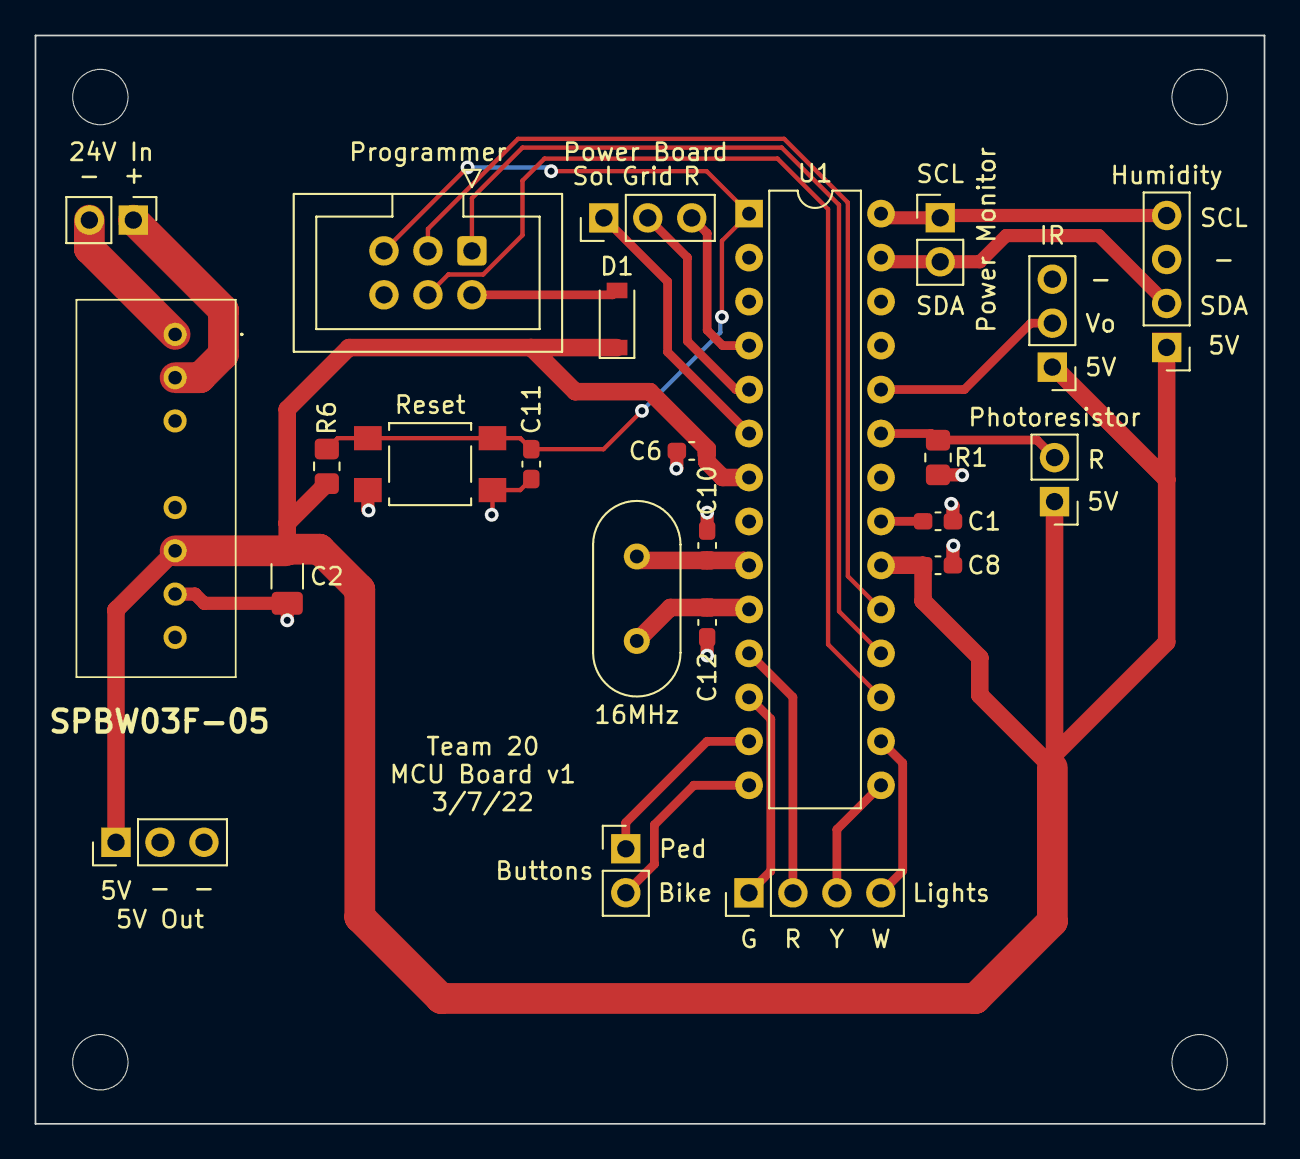
[picture p65: board mcu_board.kicad_pcb from above]

Board: 2 copper layers, 71.0 x 62.9 mm, 28 parts (0 on the bottom side), 25 nets.
