bobo-nums/ece445/(commit log)

2022-02-10 adding power switching datasheet
2022-02-15 add datasheets + kicad
    [traffic_light.kicad_pcb, traffic_light.kicad_sch]
2022-02-15 added microcontroller schematic
    [mcu_board.kicad_pcb, mcu_board.kicad_sch, traffic_light.kicad_sch]
2022-02-15 add button + power boards
    [button_board.kicad_pcb, button_board.kicad_sch, power_board.kicad_pcb, power_board.kicad_sch]
2022-02-16 removed backups, added buck converters
    [components.xlsx, power_board.kicad_sch]
2022-02-16 adding to spreadsheet
    [components.xlsx]
2022-02-16 adding more datasheets
    [components.xlsx]
2022-02-17 added ltc4359 ckt + components
    [components.xlsx, power_board.kicad_sch]
2022-02-17 minor changes
    [components.xlsx]
2022-02-18 adding components
    [components.xlsx]
2022-02-20 add simulations
    [power_board.kicad_sch]
2022-02-22 new switching network
    [components.xlsx]
2022-02-23 fixing switching network
2022-02-23 added physical design
    [traffic light.ipt]
2022-02-24 Added sensing components and mcu
    [components.xlsx]
2022-02-24 Added phototransistor
    [components.xlsx]
2022-02-24 sepic and switching network
2022-02-24 another switching network
    [components.xlsx]
2022-02-24 uploaded first version of control flow diagram
2022-02-24 added control flow table and reformatted figures
2022-02-25 screenshots and adding components
    [components.xlsx]
2022-03-01 power board pcb
    [components.xlsx, power_board.kicad_pcb, power_board.kicad_sch]
2022-03-02 light board
    [light_board.kicad_pcb, light_board.kicad_sch]
2022-03-02 traffic lights WIP
    [button_board.kicad_pcb, button_board.kicad_sch, components.xlsx, light_board.kicad_sch, mcu_board.kicad_sch, power_board.kicad_pcb, power_board.kicad_sch]
2022-03-03 MCU board WIP
    [mcu_board.kicad_sch]
2022-03-03 light board done
    [components.xlsx, light_board.kicad_pcb, light_board.kicad_sch, power_board.kicad_pcb, power_board.kicad_sch]
2022-03-06 added isolation to power and light boards
    [components.xlsx, light_board.kicad_pcb, light_board.kicad_sch, power_board.kicad_pcb, power_board.kicad_sch]
2022-03-07 working on MCU
    [components.xlsx, mcu_board.kicad_pcb, mcu_board.kicad_sch]
2022-03-08 finished up MCU board
    [components.xlsx, mcu_board.kicad_pcb, mcu_board.kicad_sch]
2022-03-08 add light/power gerbers
    [light_board-B_Cu.gbr, light_board-B_Mask.gbr, light_board-B_Paste.gbr, light_board-B_Silkscreen.gbr, light_board-Edge_Cuts.gbr, light_board-F_Cu.gbr, light_board-F_Mask.gbr, light_board-F_Paste.gbr]
2022-03-08 finishing up MCU and adding gerbers
    [components.xlsx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]
2022-03-22 Added library to read from humidity sensor
2022-03-26 light board v2 wip, 3/25/22
    [light_board.kicad_sch]
2022-03-27 Added state machine and bike interrupt
2022-03-28 light board v2
    [light_board.kicad_pcb, light_board.kicad_sch]
2022-03-29 update pcbs
    [light_board.kicad_pcb, light_board.kicad_sch, power_board.kicad_pcb, power_board.kicad_sch]
2022-03-29 add light/power pcb gerbers
    [light_board-B_Cu.gbr, light_board-B_Mask.gbr, light_board-B_Paste.gbr, light_board-B_Silkscreen.gbr, light_board-Edge_Cuts.gbr, light_board-F_Cu.gbr, light_board-F_Mask.gbr, light_board-F_Paste.gbr]
2022-03-30 buck board done
    [buck_board-B_Cu.gbr, buck_board-B_Mask.gbr, buck_board-B_Paste.gbr, buck_board-B_Silkscreen.gbr, buck_board-Edge_Cuts.gbr, buck_board-F_Cu.gbr, buck_board-F_Mask.gbr, buck_board-F_Paste.gbr]
2022-04-08 fixed button interrupt, ir sensor working
    [control-code.ino]
2022-04-21 Clean up, all sensors active
2022-04-24 Tuned sensors, added bike flicker
2022-04-24 Added last couple days
2022-04-25 data + 4/24
    [data.xlsx]
2022-04-25 Finishing touches, fixed edge cases
    [control-code.ino]
2022-04-25 Added arduinoISP serial pass through code
