bobo-nums/ece445/notebooks/richard/Physical_design_picture.jpeg

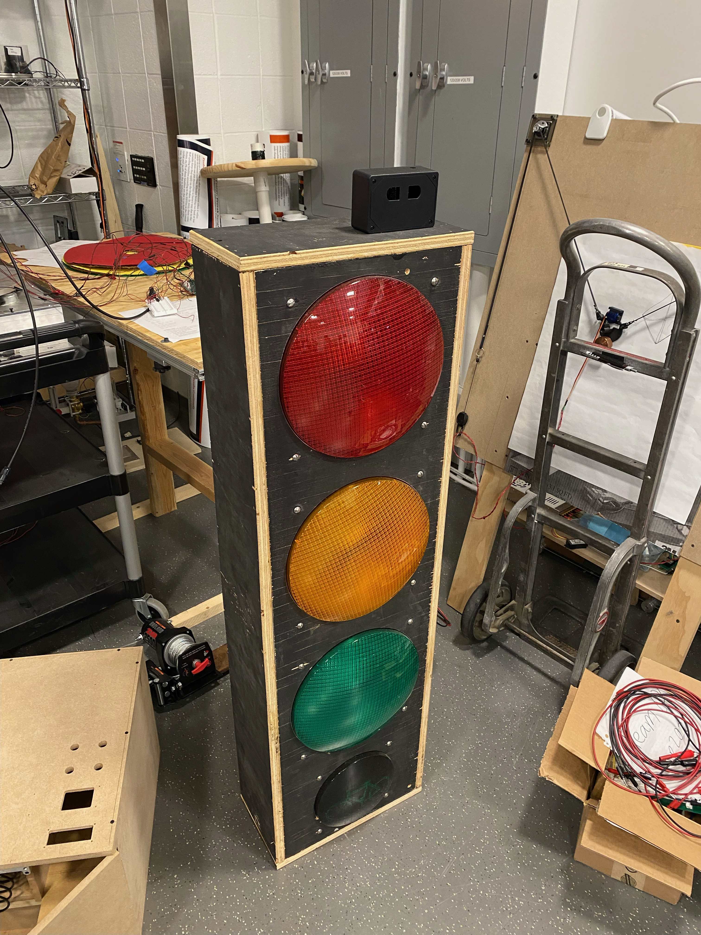
[picture p22: notebooks/richard/Physical_design_picture.jpeg]
notebooks/richard/Physical_design_picture.jpeg
